notmart/espriktning/espriktning.kicad_pcb

## KiCad design espriktning.kicad_pcb (2022-08-17)

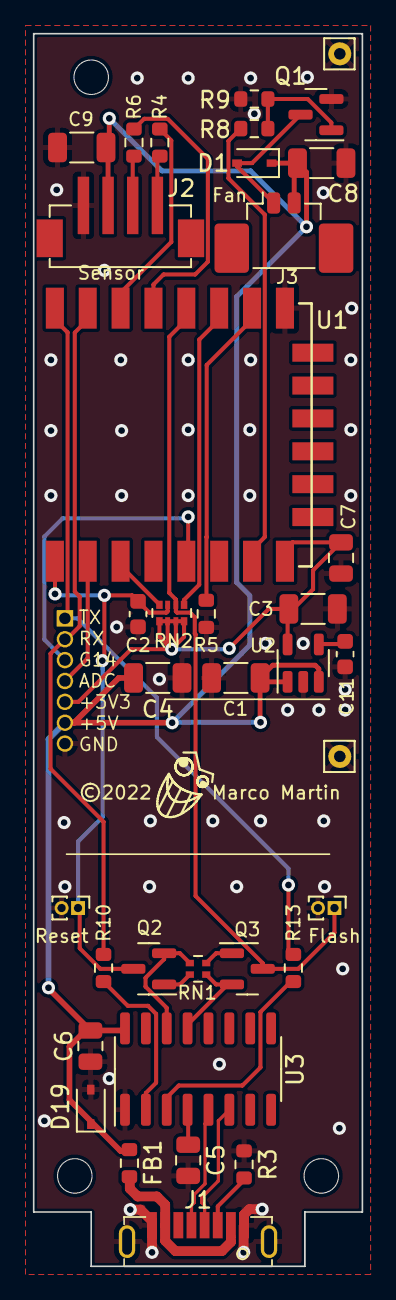
[picture p1: board espriktning.kicad_pcb from above]

Board: 2 copper layers, 20.0 x 75.0 mm, 37 parts (0 on the bottom side), 31 nets.

Parts:
C1, C3, C4, C8, C9: 10u; C_1206_3216Metric
C2, C11: 470p; C_0603_1608Metric
C5, C6: 100n; C_0805_2012Metric
C7: 100u; C_0805_2012Metric
D1, D19: 1N4007; D_SOD-323
FB1: 60R; R_0603_1608Metric
J1: USB_C_Receptacle_USB2.0; usb-c-vertical-8
J2: Conn_Sensor; X1502WVS-04-9TSN
J3: Conn_Fan; Molex_PicoBlade_53398-0271_1x02-1MP_P1.25mm_Vertical
J4: Conn_01x08; PinSocket_1x07_P1.27mm_Vertical
J6, J7: Conn_01x01_Male; Pin_D0.7mm_L6.5mm_W1.8mm_FlatFork
Q1: 2N7002K; SOT-23
Q2, Q3: S8050; SOT-23
R3: 5.1k; R_0603_1608Metric
R4, R6, R10, R13: 470R; R_0603_1608Metric
R5, R9: 12k; R_0603_1608Metric
R8: 100; R_0603_1608Metric
RN1: 10k; R_Array_Convex_2x0402
RN2: 12k; R_Array_Convex_4x0402
SW1: Reset; PinHeader_1x02_P1.00mm_Vertical
SW2: Flash; PinHeader_1x02_P1.00mm_Vertical
U1: ESP-12F; ESP-12E_SMD
U2: SPX3819M5-L-3-3_SOT-23-5; SOT-23-5
U3: CH340C; SOIC-16_3.9x9.9mm_P1.27mm

Connections:
+3V3: C3.1, C7.1, J4.5, RN2.5 (R4.2), RN2.6 (R3.2), RN2.7 (R2.2), RN2.8 (R1.2), U1.8 (VCC), U2.5 (OUT)
+5V: C1.1, C4.1, C6.1, C8.1, C9.1, D1.1 (K), D19.1 (K), FB1.2, J2.2, J3.2, J4.6, U2.1 (IN), U2.3 (EN), U3.16 (VCC)
/D_N: J1.B7 (D-), U3.6 (UD-)
/D_P: J1.B6 (D+), U3.5 (UD+)
/VBUS: FB1.1, J1.A4 (VBUS)
ADC: J4.4, U1.2 (ADC)
GND: C1.2, C2.2, C3.2, C4.2, C5.2, C6.2, C7.2, C8.2, C9.2, C11.2, D19.2 (A), J1.A1 (GND), J1.S1 (SHIELD), J2.1, J4.7, J6.1, J7.1, Q1.2 (S), R3.1, R5.2, R9.2, SW1.2, SW2.2, U1.9 (GND), U2.2 (GND), U3.1 (GND)
GPIO0: Q3.3 (C), RN2.2 (R2.1), SW2.1, U1.12 (GPIO0)
GPIO2: RN2.1 (R1.1), U1.11 (GPIO2)
GPIO4: R6.2, U1.13 (GPIO4)
GPIO5: R4.2, U1.14 (GPIO5)
GPIO13: R8.2, U1.7 (GPIO13)
GPIO14: J4.3, U1.5 (GPIO14)
GPIO15: R5.1, U1.10 (GPIO15)
unnamed: C5.1, U3.4 (V3)
unnamed: C11.1, U2.4 (BP)
unnamed: D1.2 (A), J3.1, Q1.3 (D)
unnamed: J1.A5 (CC1), R3.2
unnamed: J2.3, R6.1
unnamed: J2.4, R4.1
unnamed: Q1.1 (G), R8.1, R9.1
unnamed: Q2.1 (B), RN1.2 (R1.2)
unnamed: Q2.2 (E), RN1.4 (R2.2), U3.14 (~RTS)
unnamed: Q3.1 (B), RN1.3 (R2.1)
unnamed: Q3.2 (E), RN1.1 (R1.1), U3.13 (~DTR)
unnamed: R10.2, U3.2 (TXD)
unnamed: R13.2, U3.3 (RXD)
unnamed: RN2.4 (R4.1), U1.3 (CH_PD)
RST: C2.1, Q2.3 (C), RN2.3 (R3.1), SW1.1, U1.1 (REST)
RX: J4.2, R10.1, U1.15 (RXD)
TX: J4.1, R13.1, U1.16 (TXD)
