notmart/espriktning/rear/espriktning-rear.sch.kicad_pcb

## KiCad design rear/espriktning-rear.sch.kicad_pcb (2022-05-05)

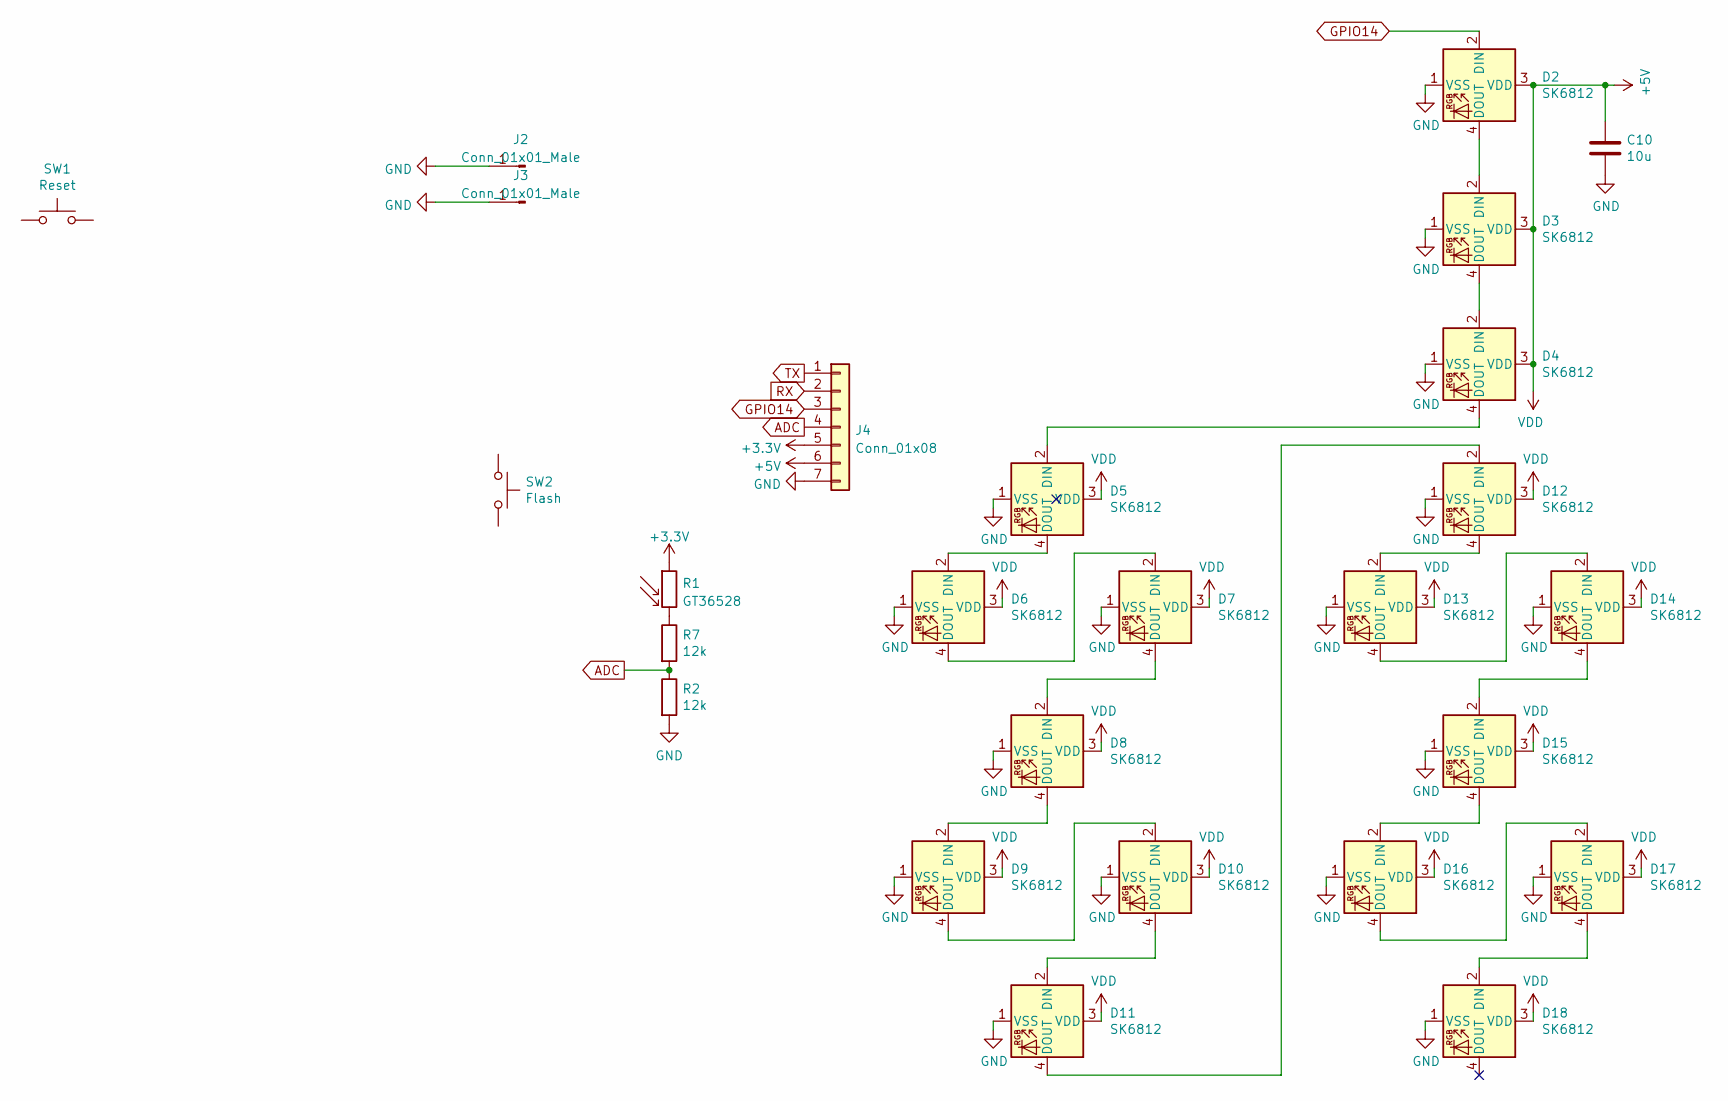
[picture p2: schematic espriktning-rear.sch.kicad_sch, ESPriktning]

Parts:
C10: 10u; C_1206_3216Metric; LCSC C9807
D2, D3, D4, D5, D6, D7, D8, D9, D10, D11, D12, D13, D14, D15, D16, D17, D18: SK6812; SK6812D-EC3210R; LCSC C2890041
J2, J3: Conn_01x01_Male; Pin_D0.7mm_L6.5mm_W1.8mm_FlatFork
J4: Conn_01x08; PinSocket_1x07_P1.27mm_Vertical
R1: GT36528; R_1210_3225Metric; LCSC C2904881
R2, R7: 12k; R_0603_1608Metric; LCSC C98220
SW1: Reset; PinHeader_1x02_P1.00mm_Vertical
SW2: Flash; PinHeader_1x02_P1.00mm_Vertical

Connections:
+3V3: J4.5, R1.1
+5V: C10.1, D2.3 (VDD), D3.3 (VDD), D4.3 (VDD), D5.3 (VDD), D6.3 (VDD), D7.3 (VDD), D8.3 (VDD), D9.3 (VDD), D10.3 (VDD), D11.3 (VDD), D12.3 (VDD), D13.3 (VDD), D14.3 (VDD), D15.3 (VDD), D16.3 (VDD), D17.3 (VDD), D18.3 (VDD), J4.6
ADC: J4.4, R2.1, R7.2
GND: C10.2, D2.1 (VSS), D3.1 (VSS), D4.1 (VSS), D5.1 (VSS), D6.1 (VSS), D7.1 (VSS), D8.1 (VSS), D9.1 (VSS), D10.1 (VSS), D11.1 (VSS), D12.1 (VSS), D13.1 (VSS), D14.1 (VSS), D15.1 (VSS), D16.1 (VSS), D17.1 (VSS), D18.1 (VSS), J2.1, J3.1, J4.7, R2.2, SW1.2, SW2.2
GPIO14: D2.2 (DIN), J4.3
unnamed: D2.4 (DOUT), D3.2 (DIN)
unnamed: D3.4 (DOUT), D4.2 (DIN)
unnamed: D4.4 (DOUT), D5.2 (DIN)
unnamed: D5.4 (DOUT), D6.2 (DIN)
unnamed: D6.4 (DOUT), D7.2 (DIN)
unnamed: D7.4 (DOUT), D8.2 (DIN)
unnamed: D8.4 (DOUT), D9.2 (DIN)
unnamed: D9.4 (DOUT), D10.2 (DIN)
unnamed: D10.4 (DOUT), D11.2 (DIN)
unnamed: D11.4 (DOUT), D12.2 (DIN)
unnamed: D12.4 (DOUT), D13.2 (DIN)
unnamed: D13.4 (DOUT), D14.2 (DIN)
unnamed: D14.4 (DOUT), D15.2 (DIN)
unnamed: D15.4 (DOUT), D16.2 (DIN)
unnamed: D16.4 (DOUT), D17.2 (DIN)
unnamed: D17.4 (DOUT), D18.2 (DIN)
unnamed: R1.2, R7.1
RX: J4.2
TX: J4.1

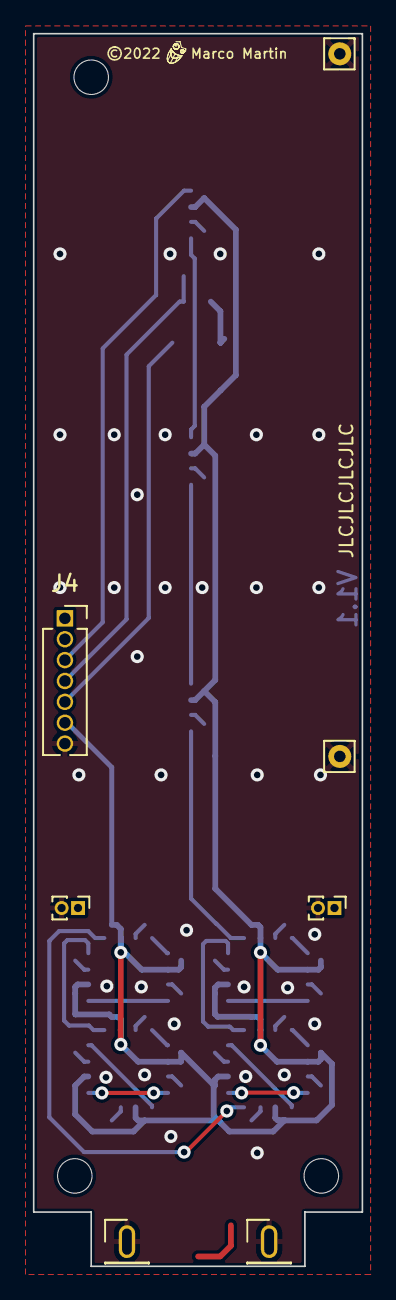
[picture p3: board espriktning-rear.sch.kicad_pcb from above]

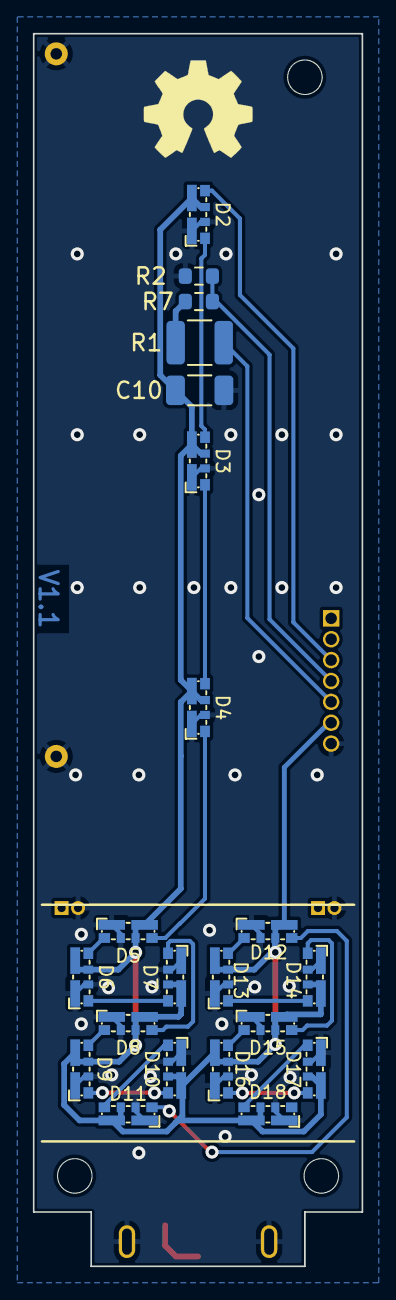
[picture p4: board espriktning-rear.sch.kicad_pcb from below]

Board: 2 copper layers, 20.0 x 75.0 mm, 26 parts (21 on the bottom side), 22 nets.
