notmart/espriktning/arduino/CommandLine.cpp

/*
 *   Copyright 2022 Marco Martin <notmart@gmail.com>
 *
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
 *   You should have received a copy of the GNU Library General Public
 *   License along with this program; if not, write to the
 *   Free Software Foundation, Inc.,
 *   51 Franklin Street, Fifth Floor, Boston, MA  02110-1301, USA.
 */
 
#include <Arduino.h>
#include "CommandLine.h"
#include "Settings.h"

void showHelp()
{
    Serial.println("Commands:");
    Serial.println("help                   Shows this help");
    Serial.println("reboot                 Reboots the device");
    Serial.println("printwifisettings      Prints SSID and password of the current wifi connection");
    Serial.println("connectwifi SSID pass  Attempts to connect to a new wifi network");
    Serial.println("testnumber  num        Tests the number and color animation with the given 0-99 number");
    Serial.println("printsettings          Prints all available settings");
    Serial.println("get config_key         Prints the value of the given config key");
    Serial.println("set config_key value   Sets the value of the given config key to the given value");
    Serial.println("factoryreset           Forgets wifi and other settings, starts as new");
}

bool isNumber(const String &string) {
    for (int i = 0; i < string.length(); ++i) {
        if (!isDigit(string[i])) {
            return false;
        }
    }
    return true;
}

void parseCommand(Tokenizer &tokenizer, WifiMQTTManager &manager, SegmentPixels &pixels)
{
    if (tokenizer.numTokens() == 1) {
        if (tokenizer[0] == "help") {
            showHelp();
        } else if (tokenizer[0] == "factoryreset") {
            manager.factoryReset();
        } else if (tokenizer[0] == "reboot") {
            ESP.reset();
        } else if (tokenizer[0] == "printsettings") {
            Settings::self()->printSettings();
        } else if (tokenizer[0] == "printwifisettings") {
            Serial.print("SSID: ");
            Serial.println(manager.getWifiSSID());
            Serial.print("Pass: ");
            Serial.println(manager.getWifiPass());
            Serial.print("IP:   ");
            Serial.println(WiFi.localIP());
        }
    } else if (tokenizer.numTokens() == 2 && tokenizer[0] == "testnumber") {
        const String numStr = tokenizer[1];
        if (!isNumber(numStr)) {
            Serial.println("Number expected");
            return;
        }
        pixels.setPM25ColorNumber(numStr.toInt());
    } else if (tokenizer.numTokens() == 2 && tokenizer[0] == "get") {
        const String key = tokenizer[1];
        if (tokenizer[1] == "use_wifi") {
            Serial.println(Settings::self()->useWifi() ? "true" : "false");
        } else if (key == "led_intensity_at_day") {
            Serial.println(Settings::self()->ledIntensityAtDay());
        } else if (key == "led_intensity_at_night") {
            Serial.println(Settings::self()->ledIntensityAtNight());
        } else if (key == "animation_duration") {
            Serial.println(Settings::self()->animationDuration());
        } else if (key == "pm2_5_topic") {
            Serial.println(Settings::self()->pm2_5Topic());
#if USE_AHT10
        } else if (key == "temperature_topic") {
            Serial.println(Settings::self()->temperatureTopic());
        } else if (key == "humiditytopic") {
            Serial.println(Settings::self()->humidityTopic());
#endif
        } else if (key == "mqtt_server") {
            Serial.println(Settings::self()->mqttServer());
        } else if (key == "mqtt_port") {
            Serial.println(Settings::self()->mqttPort());
        } else if (key == "mqtt_user_name") {
            Serial.println(Settings::self()->mqttUserName());
        } else if (key == "mqtt_password") {
            Serial.println(Settings::self()->mqttPassword());
        } else {
            Serial.print("Invalid configuration key: ");
            Serial.println(key);
        }
    } else if (tokenizer.numTokens() == 3 && tokenizer[0] == "set") {
        const String key = tokenizer[1];
        const String val = tokenizer[2];
        if (tokenizer[1] == "use_wifi") {
            if (val == "true") {
                Settings::self()->setUseWifi(true);
            } else if (val == "false") {
                Settings::self()->setUseWifi(false);
            } else {
                Serial.println("Expected: set use_wifi [true|false]");
            }
        } else if (key == "led_intensity_at_day") {
            if (!isNumber(val)) {
                Serial.println("Expected: set led_intensity_at_day 0-100");
            } else {
                int intensity = val.toInt();
                if (intensity < 0 || intensity > 100) {
                    Serial.println("Expected: set led_intensity_at_day 0-100");
                } else {
                   Settings::self()->setLedIntensityAtDay(intensity);
                }
            }
        } else if (key == "led_intensity_at_night") {
            if (!isNumber(val)) {
                Serial.println("Expected: set led_intensity_at_night 0-100");
            } else {
                int intensity = val.toInt();
                if (intensity < 0 || intensity > 100) {
                    Serial.println("Expected: set led_intensity_at_night 0-100");
                } else {
                   Settings::self()->setLedIntensityAtNight(intensity);
                }
            }
        } else if (key == "animation_duration") {
            if (!isNumber(val)) {
                Serial.println("Expected: set animation_duration 0-4000");
            } else {
                int duration = val.toInt();
                if (duration < 0 || duration > 4000) {
                    Serial.println("Expected: set animation_duration 0-4000");
                } else {
                   Settings::self()->setAnimationDuration(duration);
                   pixels.setAnimationDuration(duration);
                }
            }
        } else if (key == "pm2_5_topic") {
            Settings::self()->setPm2_5Topic(val);
#if USE_AHT10
        } else if (key == "temperature_topic") {
            Settings::self()->setTemperatureTopic(val);
        } else if (key == "humidity_topic") {
            Settings::self()->setHumidityTopic(val);
#endif
        } else if (key == "mqtt_server") {
            Settings::self()->setMqttServer(val);
        } else if (key == "mqtt_port") {
            if (!isNumber(val)) {
                Serial.println("Expected: set mqtt_port 1-65535");
            } else {
                int port = val.toInt();
                if (port < 0 || port > 65535) {
                    Serial.println("Expected: set mqtt_port 0-65535");
                } else {
                   Settings::self()->setMqttPort(port);
                }
            }
        } else if (key == "mqtt_user_name") {
            Settings::self()->setMqttUserName(val);
        } else if (key == "mqtt_password") {
            Settings::self()->setMqttPassword(val);
        } else {
            Serial.print("Invalid configuration key: ");
            Serial.println(key);
        }
    } else if (tokenizer.numTokens() == 3 && tokenizer[0] == "connectwifi") {
        //FIXME: find a way
        const String ssid = tokenizer[1];
        const String pass = tokenizer[2];
        WiFi.persistent(true);
        bool ret = WiFi.begin(ssid.c_str(), pass.c_str(), 0, NULL, true);
        if (!ret) {
            Serial.println("[Error] wifi connection failed");
        }
        Serial.println(WiFi.isConnected());
        WiFi.persistent(false);
    } else {
        Serial.println("Syntax error, available commands are:");
        showHelp();
    }
}
