notmart/espriktning/(commit log)

2022-04-17 remove zipped gerbers
2022-04-17 separate file for the rear
    [espriktning (phobos's conflicted copy 2022-04-14).kicad_sch, espriktning-rear.sch.csv, espriktning-rear.sch.kicad_pcb, espriktning-rear.sch.kicad_sch, espriktning-rear.sch.sch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]
2022-05-05 relayout to actually fit
    [espriktning-rear.sch.kicad_pcb, espriktning-rear.sch.kicad_sch, espriktning.kicad_pcb, espriktning.kicad_sch]
2022-05-05 update gerber
    [espriktning-B_Cu.gbr, espriktning-B_Mask.gbr, espriktning-B_Paste.gbr, espriktning-B_Silkscreen.gbr, espriktning-Edge_Cuts.gbr, espriktning-F_Cu.gbr, espriktning-F_Mask.gbr, espriktning-F_Paste.gbr]
2022-05-05 add gerber
    [espriktning-rear.sch-B_Cu.gbr, espriktning-rear.sch-B_Mask.gbr, espriktning-rear.sch-B_Paste.gbr, espriktning-rear.sch-B_Silkscreen.gbr, espriktning-rear.sch-Edge_Cuts.gbr, espriktning-rear.sch-F_Cu.gbr, espriktning-rear.sch-F_Mask.gbr, espriktning-rear.sch-F_Paste.gbr]
2022-05-18 Add the arduino sketch
    [espriktning.kicad_pcb]
2022-05-30 fix settings save/restore and colors
    [CommandLine.cpp, CommandLine.h, SegmentPixels.cpp, SegmentPixels.h, Settings.cpp, WifiMQTTManager.cpp, espriktning.ino]
2022-08-17 fix usb power
    [espriktning.kicad_pcb, espriktning.kicad_sch]
2022-08-19 support for optional aht10
    [espriktning.kicad_sch]
2022-08-19 little adjustment for temperature color
2026-03-13 Better manage when the tem sensor is not attached
    also, watchdog and less insistent to connect to mqtt
